npe9/upsat-comms-hardware/antenna_release_mechanism/lidAssembly.fcstd

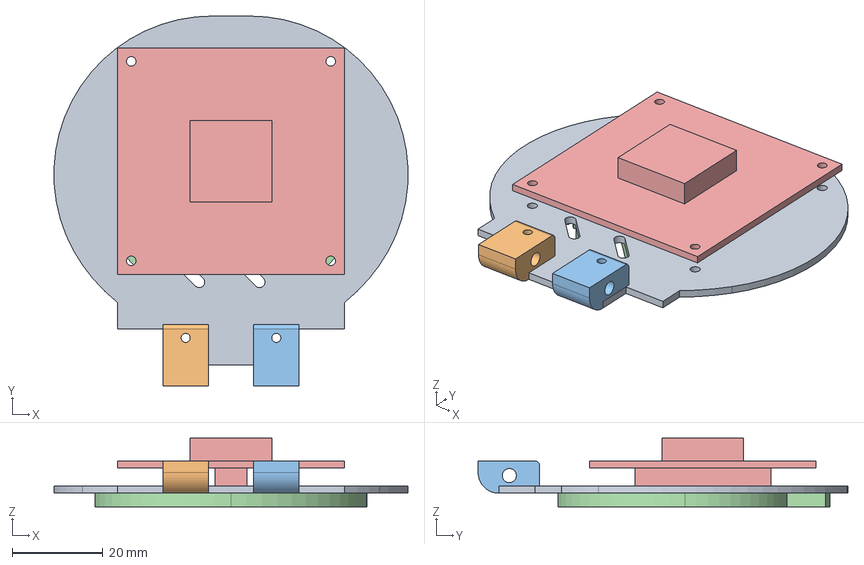
[picture p1: CAD file, 2016-03-28]
antenna_release_mechanism/lidAssembly.fcstd
78.1 x 81.6 x 15.2 mm
lidFR4_01
lidHinge_01
lidHinge_02
spool_01
GPS_antenna_01
