npe9/upsat-comms-hardware/antenna_release_mechanism/frameAssembly.fcstd

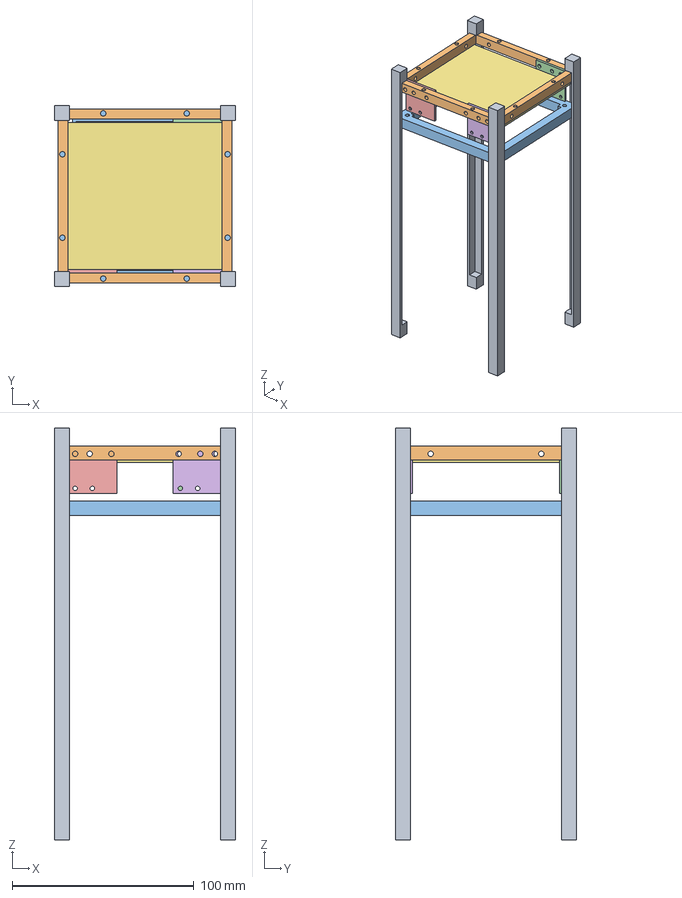
[picture p2: CAD file, 2016-03-15]
antenna_release_mechanism/frameAssembly.fcstd
100.0 x 100.0 x 227.0 mm
rods_01
frameDown_01
frameUp_01
switchHolder_01
switchHolder_02
switchHolder_03
base_01
