npe9/upsat-comms-hardware/antenna_release_mechanism/GPS_antenna.fcstd

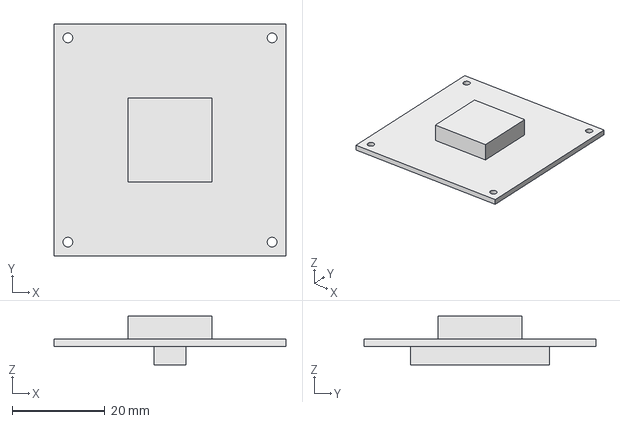
[picture p3: CAD file, 2016-03-28]
antenna_release_mechanism/GPS_antenna.fcstd
50.0 x 50.0 x 10.6 mm
