npe9/upsat-comms-hardware/antenna_release_mechanism/base.fcstd

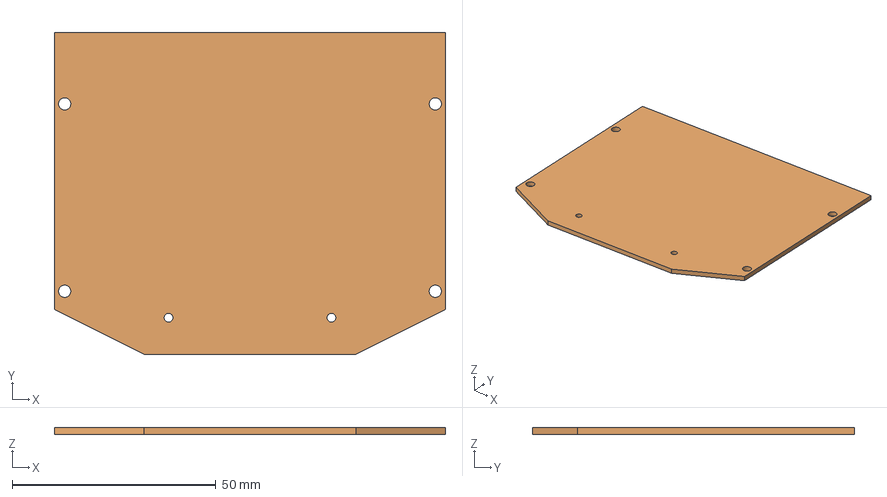
[picture p4: CAD file, 2016-03-28]
antenna_release_mechanism/base.fcstd
96.0 x 79.0 x 1.60 mm
