npe9/upsat-comms-hardware/antenna_release_mechanism/spool.fcstd

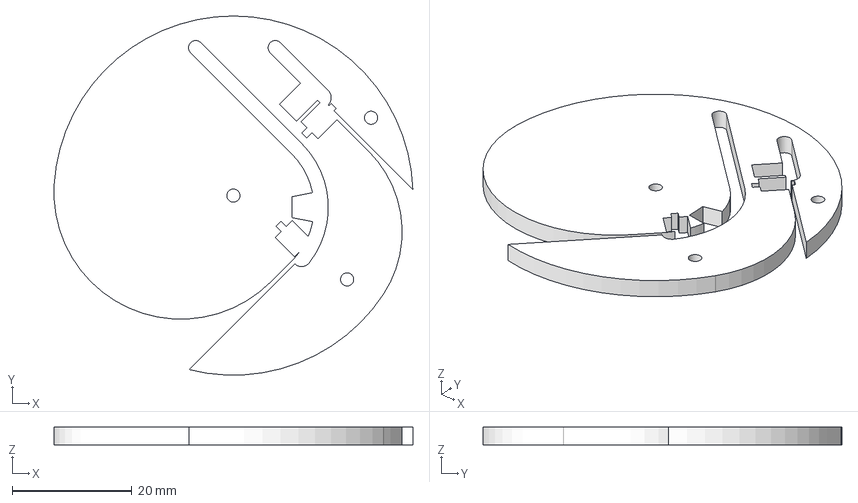
[picture p5: CAD file, 2016-03-28]
antenna_release_mechanism/spool.fcstd
59.9 x 60.0 x 3.00 mm
