npe9/upsat-comms-hardware/antenna_release_mechanism/lidMechanism.fcstd

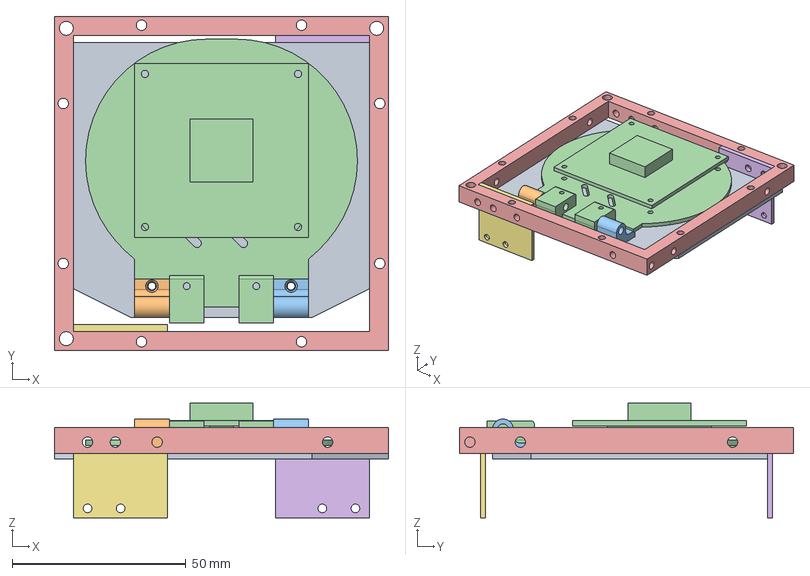
[picture p6: CAD file, 2016-03-28]
antenna_release_mechanism/lidMechanism.fcstd
96.0 x 96.0 x 33.0 mm
base_01
hingeBlock_01
hingeBlock_02
lidAssembly_01
frameDown_01
switchHolder_01
switchHolder_02
