npe9/upsat-comms-hardware/antenna_release_mechanism/lidFR4.fcstd

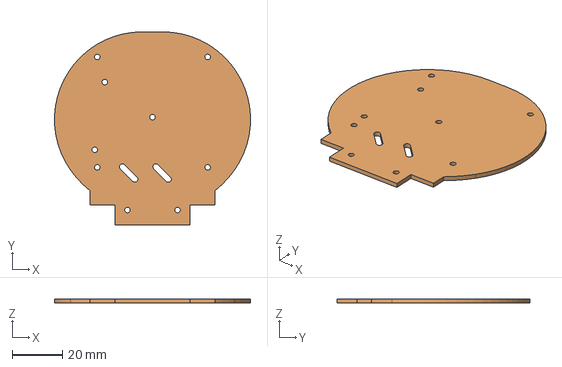
[picture p7: CAD file, 2016-03-28]
antenna_release_mechanism/lidFR4.fcstd
78.1 x 77.0 x 1.60 mm
