npe9/upsat-comms-hardware/antenna_release_mechanism/frameDown.fcstd

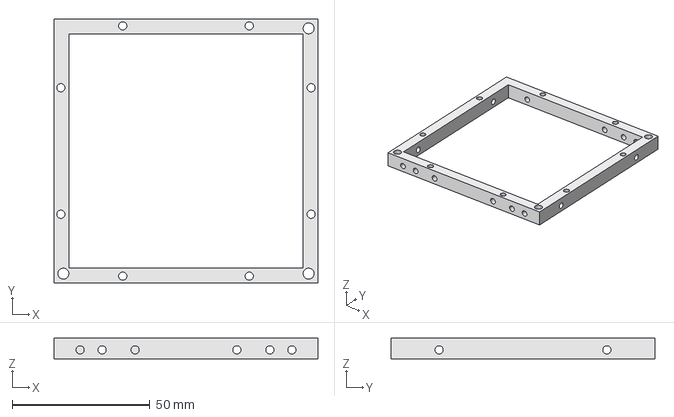
[picture p8: CAD file, 2016-03-15]
antenna_release_mechanism/frameDown.fcstd
96.0 x 96.0 x 7.50 mm
