npe9/upsat-comms-hardware/antenna_release_mechanism/hingeBlock.fcstd

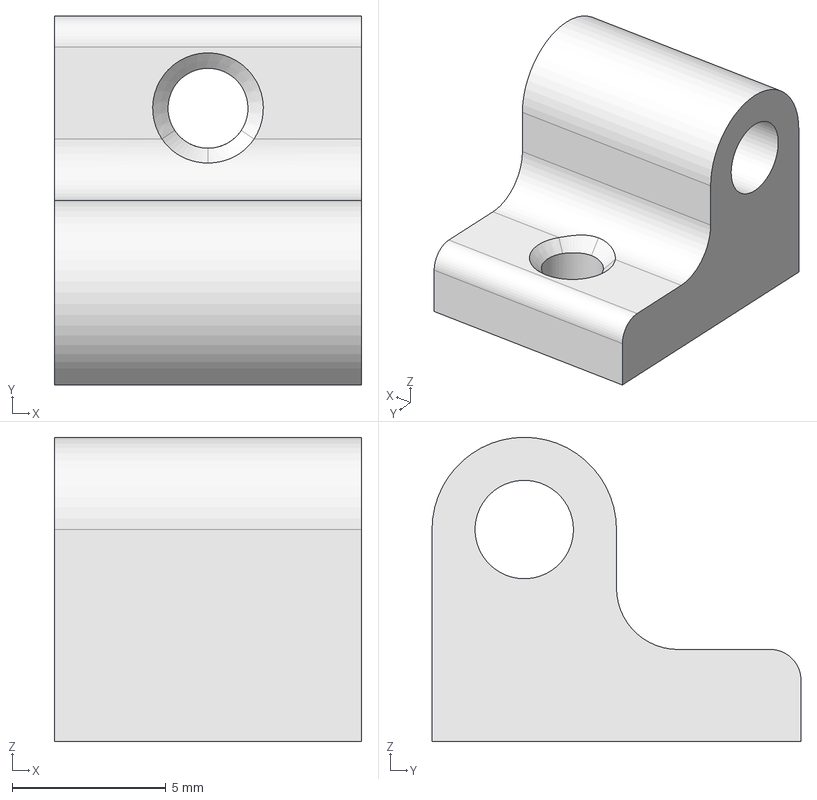
[picture p9: CAD file, 2016-03-15]
antenna_release_mechanism/hingeBlock.fcstd
10.0 x 12.0 x 9.90 mm
