npe9/upsat-comms-hardware/antenna_release_mechanism/frameUp.fcstd

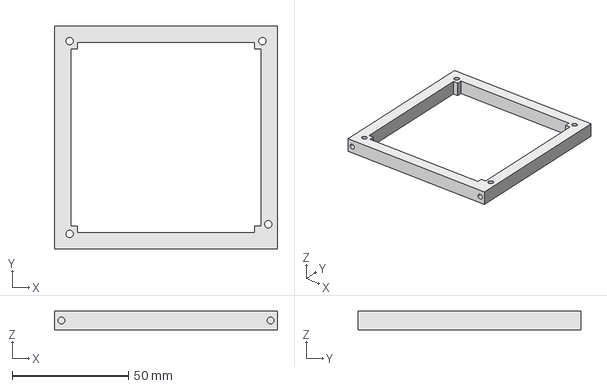
[picture p10: CAD file, 2016-03-15]
antenna_release_mechanism/frameUp.fcstd
96.0 x 96.0 x 8.00 mm
