npe9/upsat-comms-hardware/antenna_release_mechanism/rods.fcstd

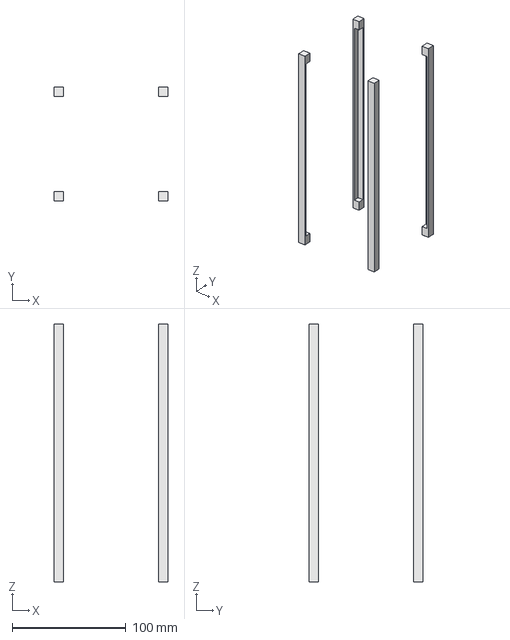
[picture p11: CAD file, 2016-03-15]
antenna_release_mechanism/rods.fcstd
100.0 x 100.0 x 227.0 mm
