npe9/upsat-comms-hardware/antenna_release_mechanism/switchHolder.fcstd

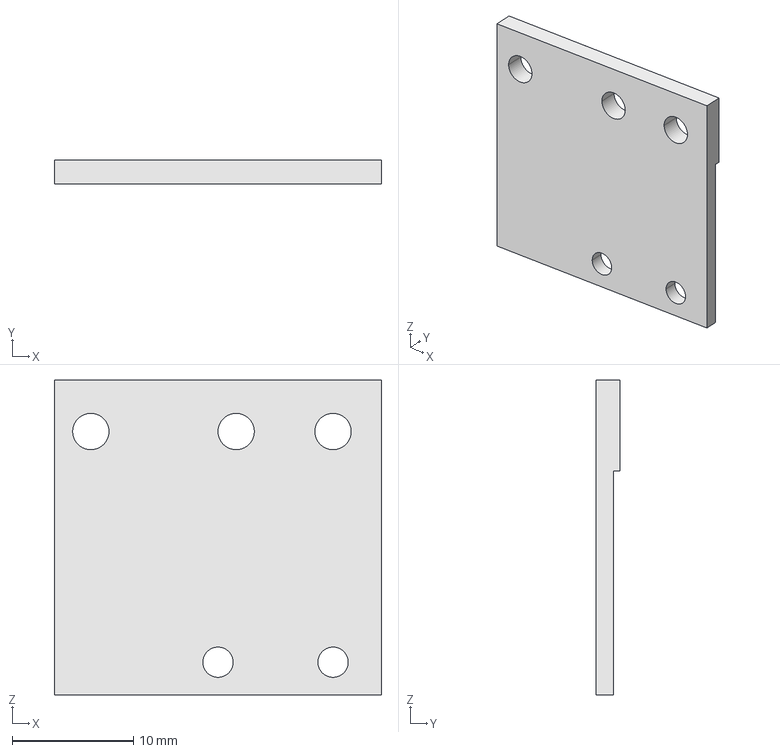
[picture p12: CAD file, 2016-03-15]
antenna_release_mechanism/switchHolder.fcstd
27.0 x 2.00 x 26.0 mm
