npe9/upsat-comms-hardware/antenna_release_mechanism/lidHinge.fcstd

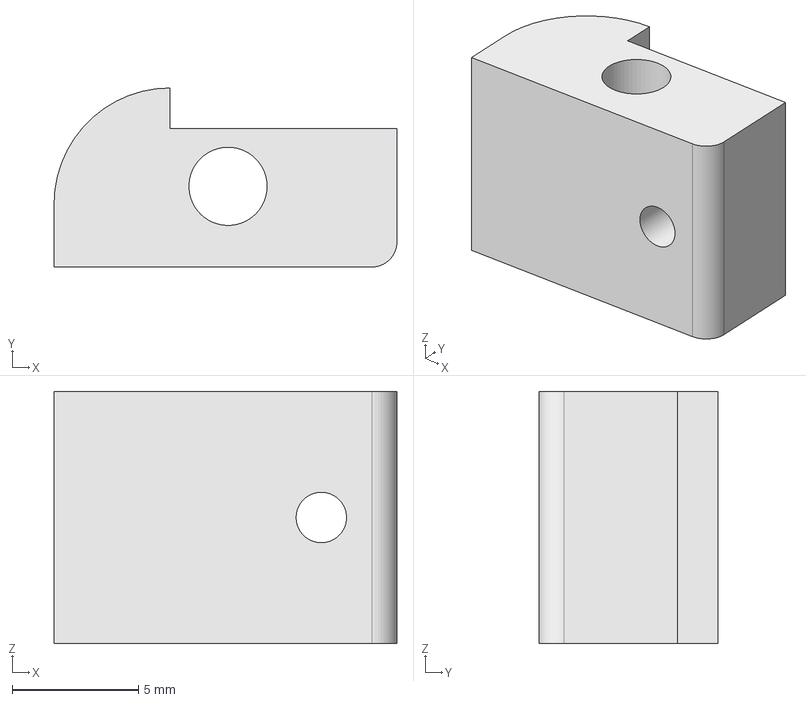
[picture p13: CAD file, 2016-03-15]
antenna_release_mechanism/lidHinge.fcstd
13.6 x 7.10 x 10.0 mm
