npe9/upsat-comms-hardware/upsat-comms-gerber/upsat-comms-hardware.pdf

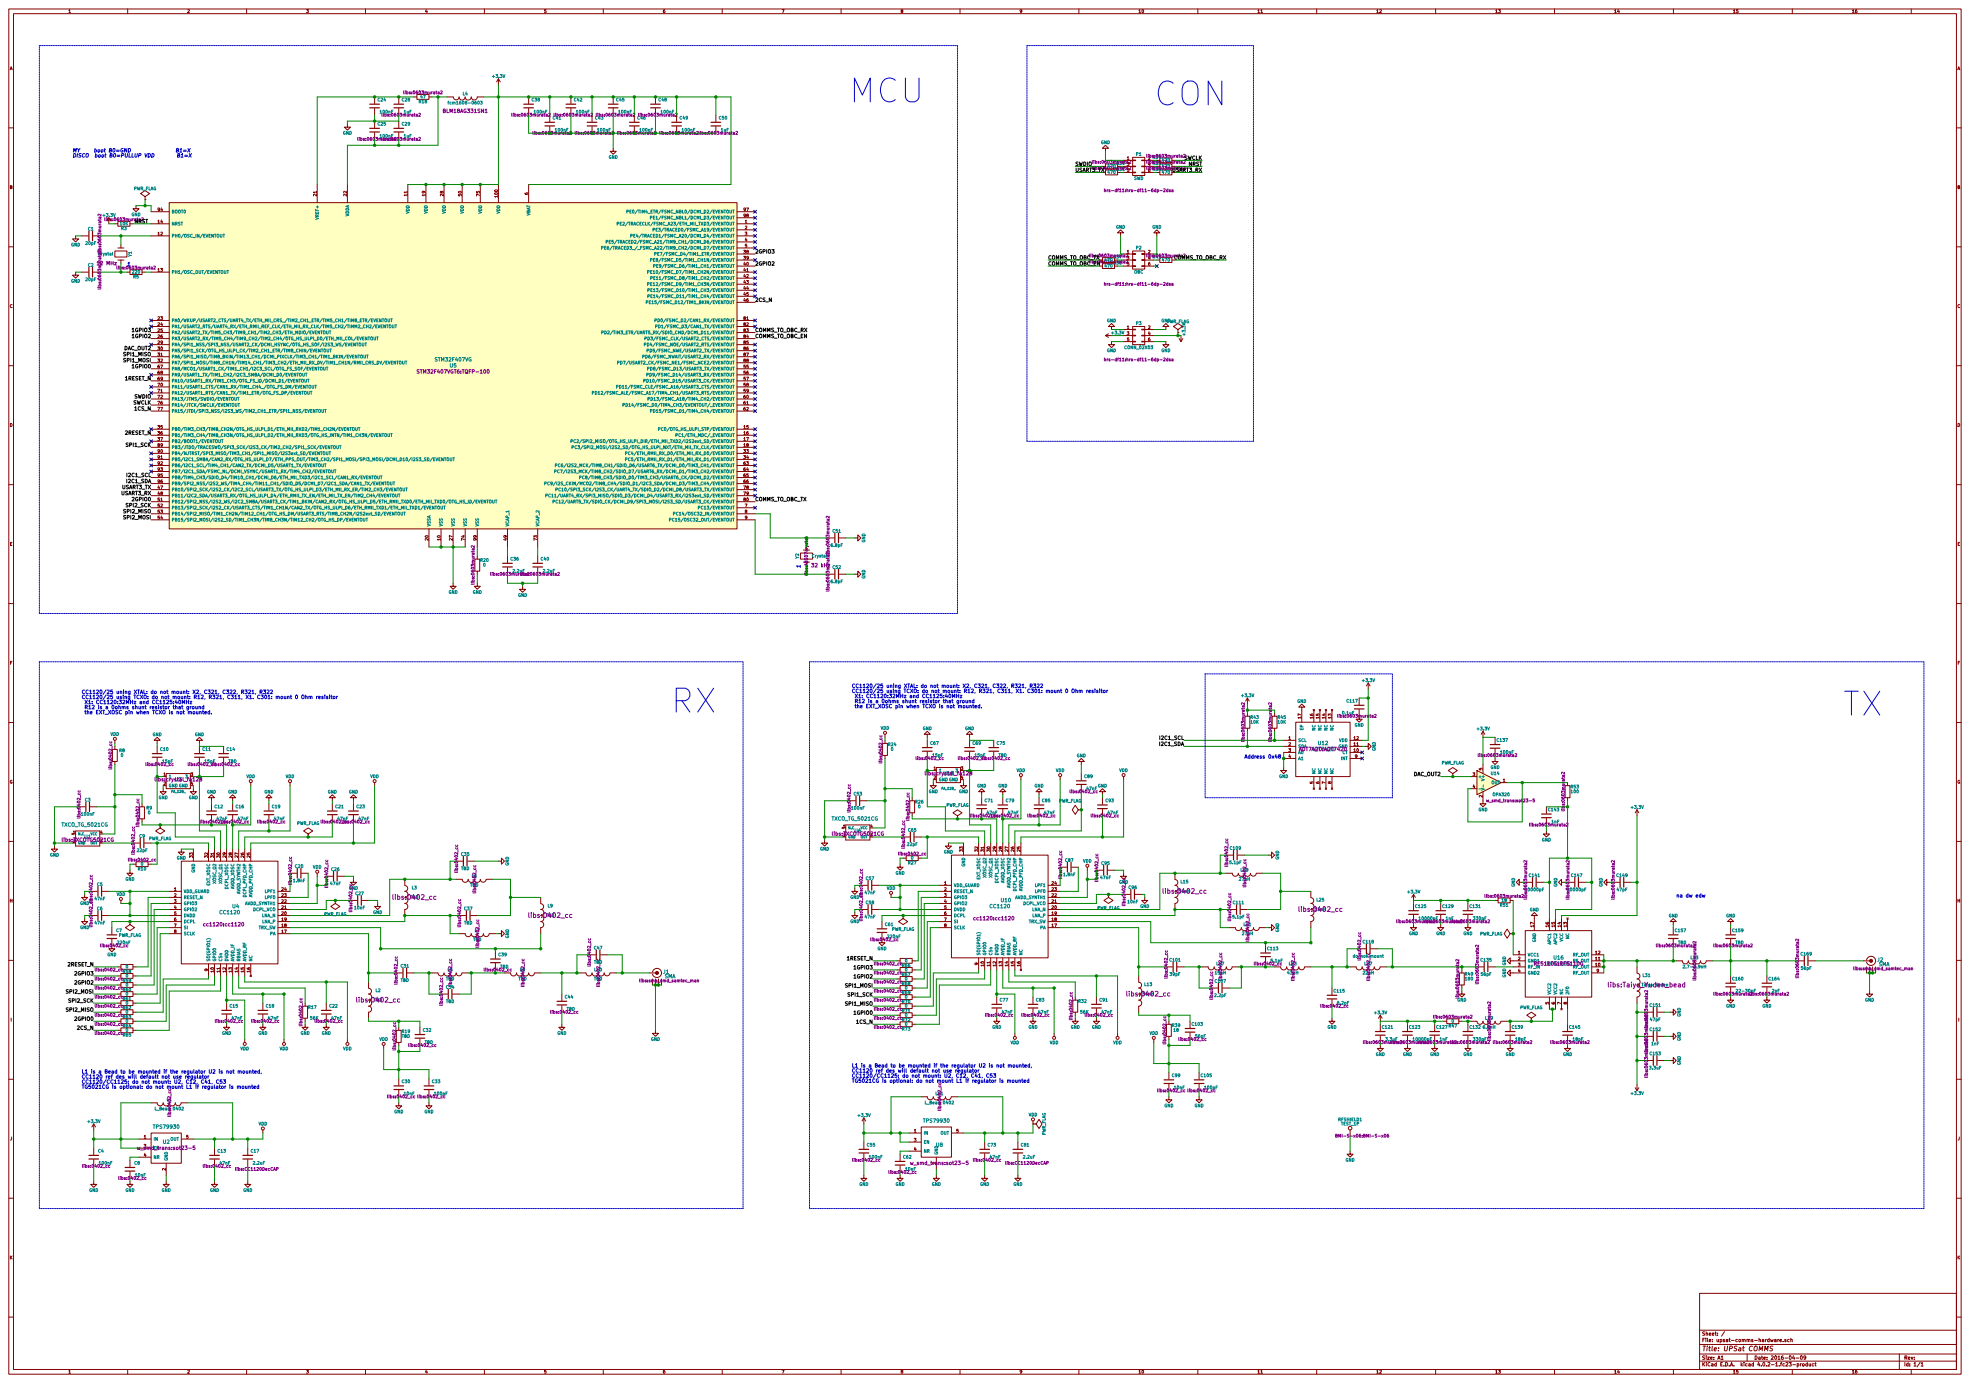
[picture p14: page 1]

6 PC13/EVENTOUT 7 PC14/OSC32_IN/EVENTOUT 8 PC15/OSC32_OUT/EVENTOUT 9 VSS 10 VSSA 20

libs:0402_cc CC1120/25 uning XTAL: do not mount: X2, C321, C322, R321, R322
CC1120/25 using TCXO: do not mount: R12, R321, C311, X1. C301: mount 0 Ohm resisitor
X1: CC1120:32MHz and CC1125:40MHz
R12 is a 0ohms shunt resistor that ground
the EXT_XOSC pin when TCXO is not mounted.

L10 TBDlibs:0402_cc C47 libs:0402_cc TBD GND

L7 TBDlibs:0402_cc L6 TBDlibs:0402_cc C37 libs:0402_cc TBD

L1 is a Bead to be mounted if the regulator U2 is not mounted,
CC1120 ref des will default not use regulator
CC1120/CC1125: do not mount: U2, C12, C41, C53

TG5021CG is optional: do not mount L1 if regulator is mounted

File: upsat-comms-hardware.sch Sheet: /
Id: 1/1 Title: UPSat COMMS
