npe9/upsat-comms-hardware/antenna_release_mechanism/pcb_bottom/pcb_bottom.kicad_pcb

## KiCad design antenna_release_mechanism/pcb_bottom/pcb_bottom.kicad_pcb (2016-04-26)

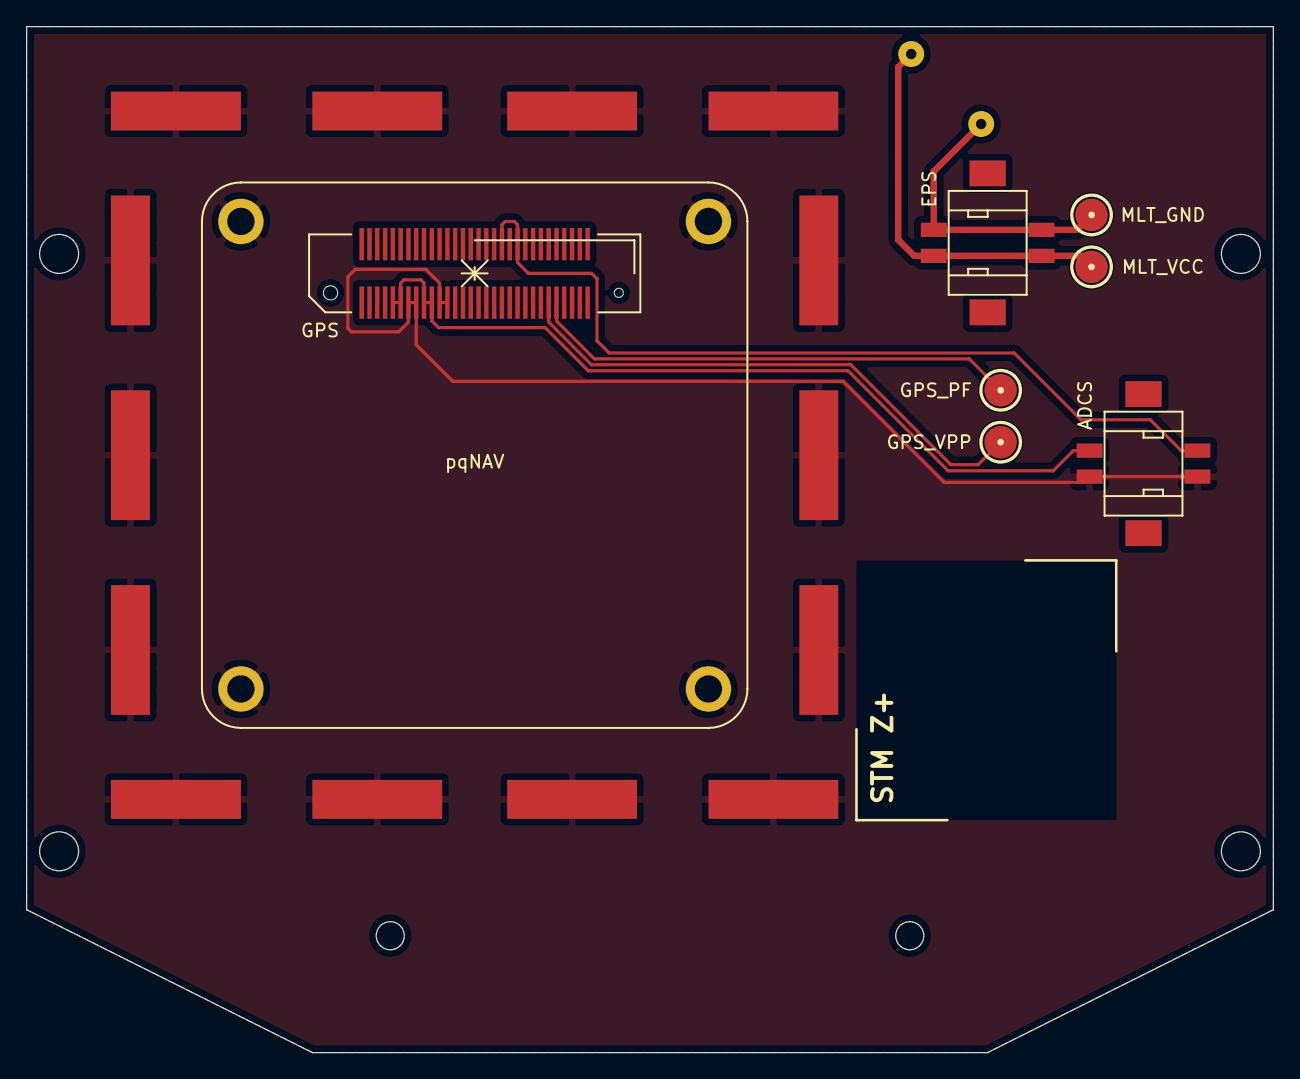
[picture p22: board pcb_bottom.kicad_pcb from above]

Board: 2 copper layers, 96.0 x 79.0 mm, 9 parts (1 on the bottom side), 7 nets.

Parts:
ADCS: CONN_02X02; hrs-df11c-4dp-2v
EPS: CONN_02X02; hrs-df11c-4dp-2v
GPS: PQ60; hrs-fx8c-60p-sv
GPS_PF: TEST_1P; testpoint_2mm5
GPS_VPP: TEST_1P; testpoint_2mm5
MLT_GND: TEST_1P; testpoint_2mm5
MLT_VCC: TEST_1P; testpoint_2mm5
R1: R; RC03
pqNAV: GPS-pqNav

Connections:
/GPS_GND: ADCS.1, ADCS.2, GPS.7, GPS.8, GPS.11, GPS.12, pqNAV.1
/GPS_PF: GPS.26, GPS_PF.1
/GPS_TXD: ADCS.4, GPS.40, GPS.42
/GPS_VDD: ADCS.3, GPS.5, GPS.6, GPS.9, GPS.10
/GPS_VPP: GPS.25, GPS_VPP.1
/MELT_GND: EPS.1, EPS.2, MLT_GND.1, R1.2
/MELT_VCC: EPS.3, EPS.4, MLT_VCC.1, R1.1
