npe9/upsat-comms-hardware/antenna_release_mechanism/pcb_top/pcb_top.kicad_pcb

## KiCad design antenna_release_mechanism/pcb_top/pcb_top.kicad_pcb (2016-03-30)

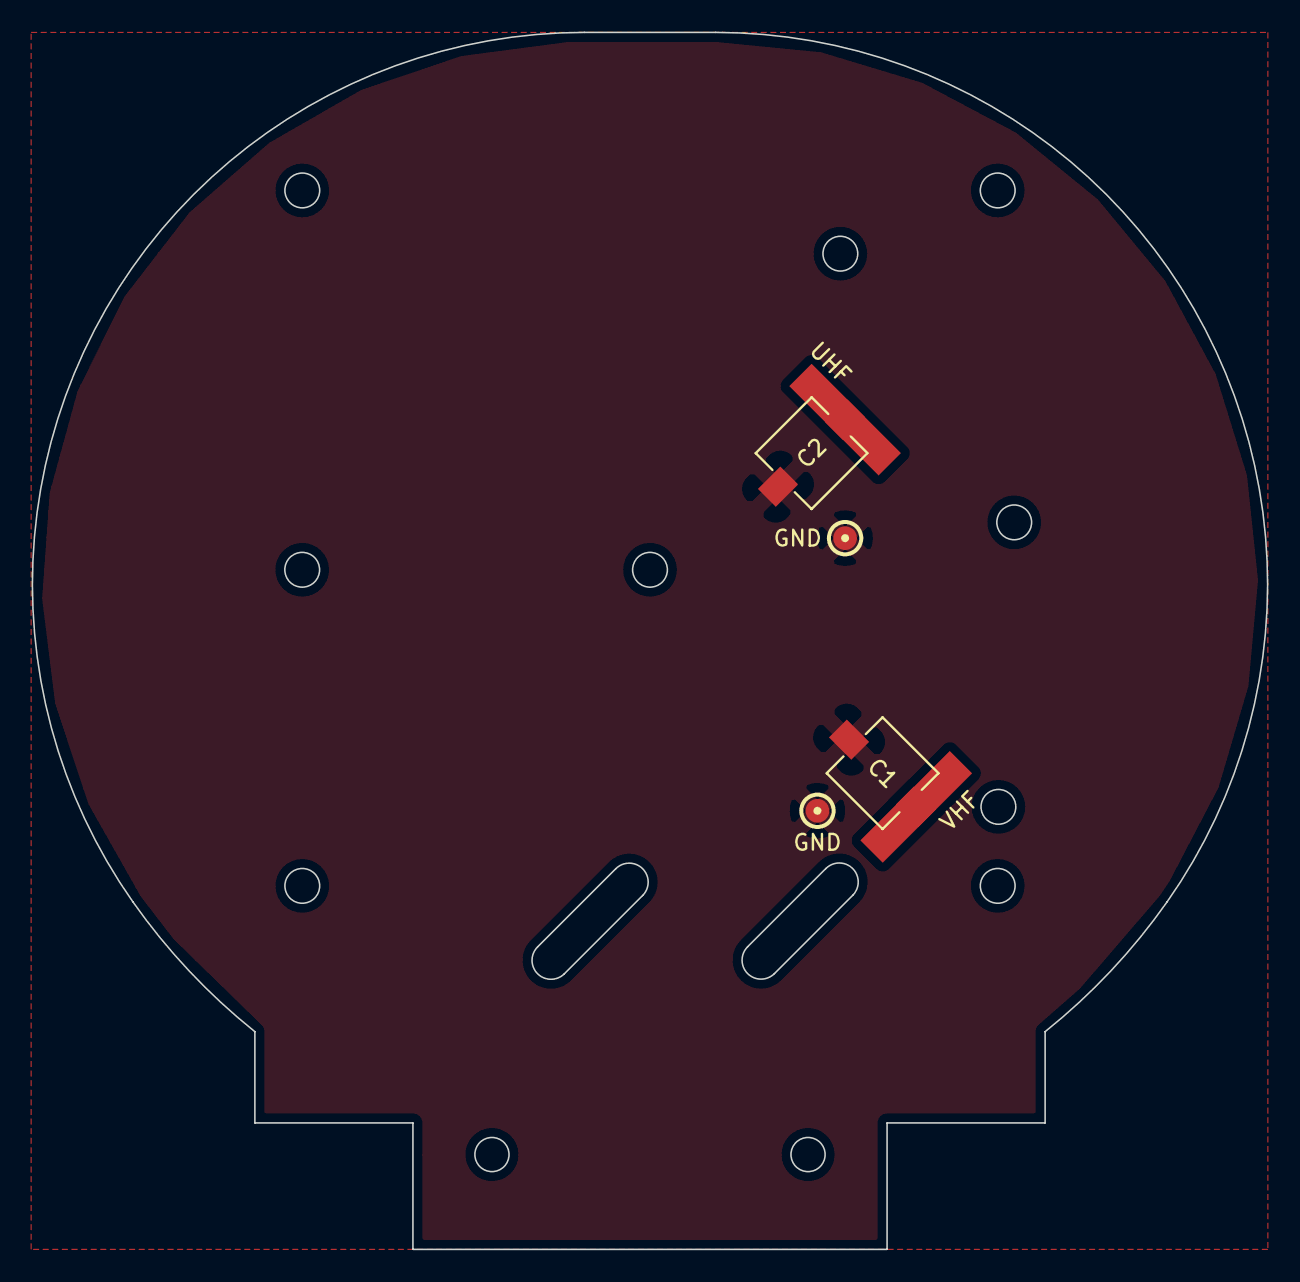
[picture p23: board pcb_top.kicad_pcb from above]

Board: 2 copper layers, 78.2 x 77.0 mm, 6 parts (0 on the bottom side), 2 nets, no tracks yet.

Parts:
C1, C2: CTRIM; murata-dzb4-b
GND: RFSHL-145; testpoint_1mm5
GND#2: RFSHL-437; testpoint_1mm5
UHF: RFSTR-437; rfstrip-144
VHF: RFSTR-145; rfstrip-144

Connections:
GND: C1.2, C2.2, GND.1, GND#2.1
VCOM: C1.1, C2.1, UHF.1, VHF.1
