npe9/upsat-comms-hardware/(commit log)

2016-02-09 First commit for antenna release mechanism.
    [assembly.fcstd, base.fcstd, lid.fcstd]
2016-02-16 [WIP] Upsat COMMS PCB
    [upsat-comms.kicad_pcb]
2016-03-13 Add KiCad libs for upsat-comms-hardware.
2016-03-15 Add up to date files before final tests.
    [GPS_antenna.fcstd, assembly.fcstd, base.fcstd, frameAssembly.fcstd, frameDown.fcstd, frameUp.fcstd, hingeBlock.fcstd, lid.fcstd]
2016-03-21 Fix lidFR4 to prevent colision with sensor holder parts.
    [lidAssembly.fcstd, lidFR4.fcstd, lidMechanism.fcstd]
2016-03-28 Add latest changes to sinc with kikad antenna matching design.
    [GPS_antenna.fcstd, base.fcstd, lidAssembly.fcstd, lidFR4.fcstd, lidMechanism.fcstd, spool.fcstd]
2016-03-30 Add PCB top design.
    [pcb_top.kicad_pcb, pcb_top.sch]
2016-03-30 GPS bottom PCB of ANT.
    [pcb_bottom.kicad_pcb, pcb_bottom.sch]
2016-03-30 Update PCB based on PTFE outline.
    [pcb_top.kicad_pcb]
2016-04-08 [WIP] 4 layer restructuring of COMMS.
    [comms-hardware-diploma-theodoridis.kicad_pcb, comms-hardware-diploma-theodoridis.sch, upsat-comms.kicad_pcb]
2016-04-09 Cleanup of zones and vias.
    [comms-hardware-diploma-theodoridis.kicad_pcb, upsat-comms-hardware.kicad_pcb, upsat-comms-hardware.sch]
2016-04-09 Restructuring libraries.
    [upsat-comms-hardware.kicad_pcb, upsat-comms-hardware.sch]
2016-04-09 Create silkscreen and reroute OBC Connector.
    [upsat-comms-hardware.kicad_pcb, upsat-comms-hardware.sch]
2016-04-09 Cleanup schematic.
    [upsat-comms-hardware.sch]
2016-04-09 Add vias on PA.
    [upsat-comms-hardware.kicad_pcb, upsat-comms-hardware.sch]
2016-04-10 Recreate zones for In2.
    [upsat-comms-hardware.kicad_pcb]
2016-04-10 New footprint for RF5110G.
    [upsat-comms-hardware.kicad_pcb]
2016-04-10 Routing changes and package fixes.
    [upsat-comms-hardware.kicad_pcb, upsat-comms-hardware.sch]
2016-04-10 Fix silkscreen specs.
    [upsat-comms-hardware.kicad_pcb, upsat-comms-hardware.sch]
2016-04-10 Exchange SOT23-5 footprint.
    [upsat-comms-hardware.kicad_pcb, upsat-comms-hardware.sch]
2016-04-11 Fix Taiyo Yuden bead footprint and placement.
    [upsat-comms-hardware.kicad_pcb]
2016-04-22 add gerber and sch pdf
    [upsat-comms-hardware-B.Cu.gbr, upsat-comms-hardware-B.Mask.gbr, upsat-comms-hardware-B.Paste.gbr, upsat-comms-hardware-B.SilkS.gbr, upsat-comms-hardware-Edge.Cuts.gbr, upsat-comms-hardware-F.Cu.gbr, upsat-comms-hardware-F.Mask.gbr, upsat-comms-hardware-F.Paste.gbr]
2016-04-26 ANT bottom antenna for GPS housing and melt line.
    [pcb_bottom.kicad_pcb]
2016-05-05 add RF values for CC1120 RX, wrong path for mmcx con.
    [upsat-comms-hardware.kicad_pcb, upsat-comms-hardware.sch]
2016-05-06 add power amp RF out component values, add comments on CC1120 TXCO-Crystal section, add comments on CC1120 regulator-bead
    [upsat-comms-hardware.kicad_pcb, upsat-comms-hardware.sch]
2016-05-06 Edit OPA R53 resistor
    It should be 180 Ohms to feed P.A AGC with 2.75 Volts.
    [upsat-comms-hardware.kicad_pcb, upsat-comms-hardware.sch]
2016-05-06 Add CC1120 bead part number
    [upsat-comms-hardware.kicad_pcb, upsat-comms-hardware.sch]
2016-05-07 Add values for P.A RF Out matching network
    [upsat-comms-hardware.kicad_pcb, upsat-comms-hardware.sch]
2017-02-28 Add UPSat RF simulations from Qucs [WIP]
    [UPSat_PA_RFOut_Sparam_TLines_SDefaultvalues.sch, UPSat_PA_RFOut_lumped_NoTLines_SDefaultvalues.sch, UPSat_Rx_Sparam_TLines_S.sch, UPSat_Rx_lumped_NoTLines_S.sch]
2022-07-05 add bom
    [upsat-comms-hardware.csv]
